profdc9/PicoAlt/README.md

# Pico Alt

This is a simplified Pi Pico board that can be fabricated by JLCPCB.  I customized it to add more flash, a linear regulator, and to be easier to modify if needed.

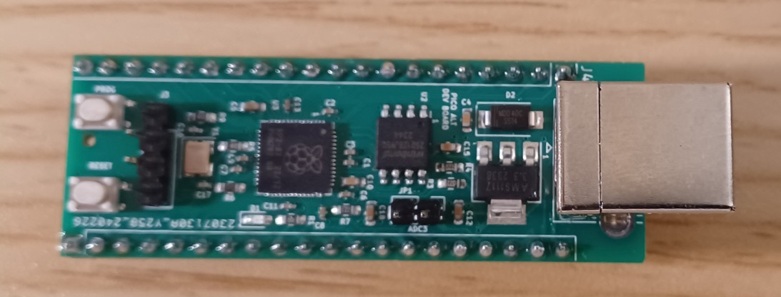
[picture p1: PicoAltPhoto.jpg]

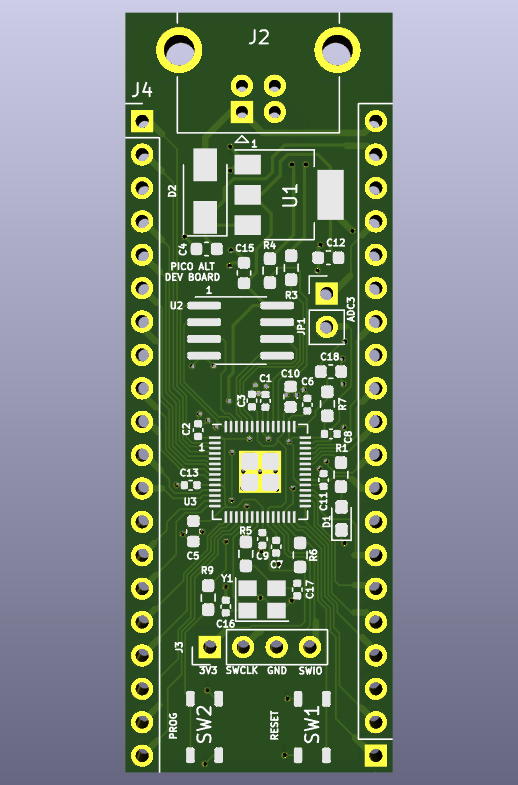
[picture p2: PicoAlt.png]

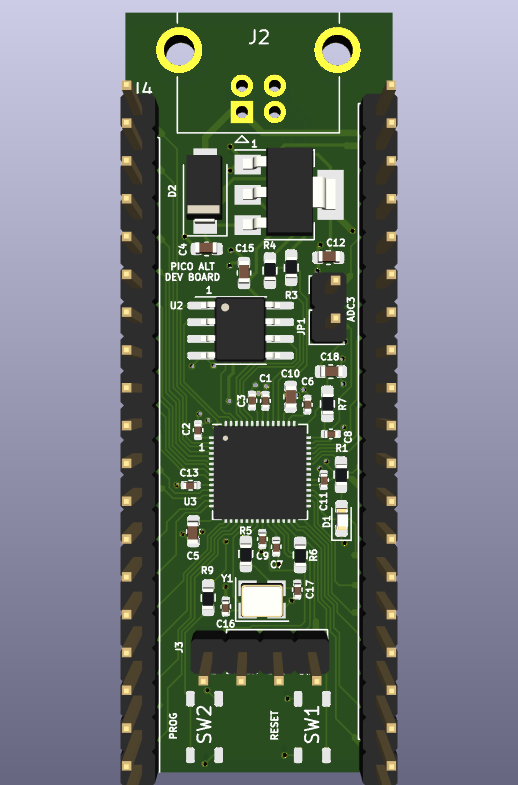
[picture p3: PicoAltComponents.png]
