profdc9/PicoAlt/PicoAlt-schematic.pdf

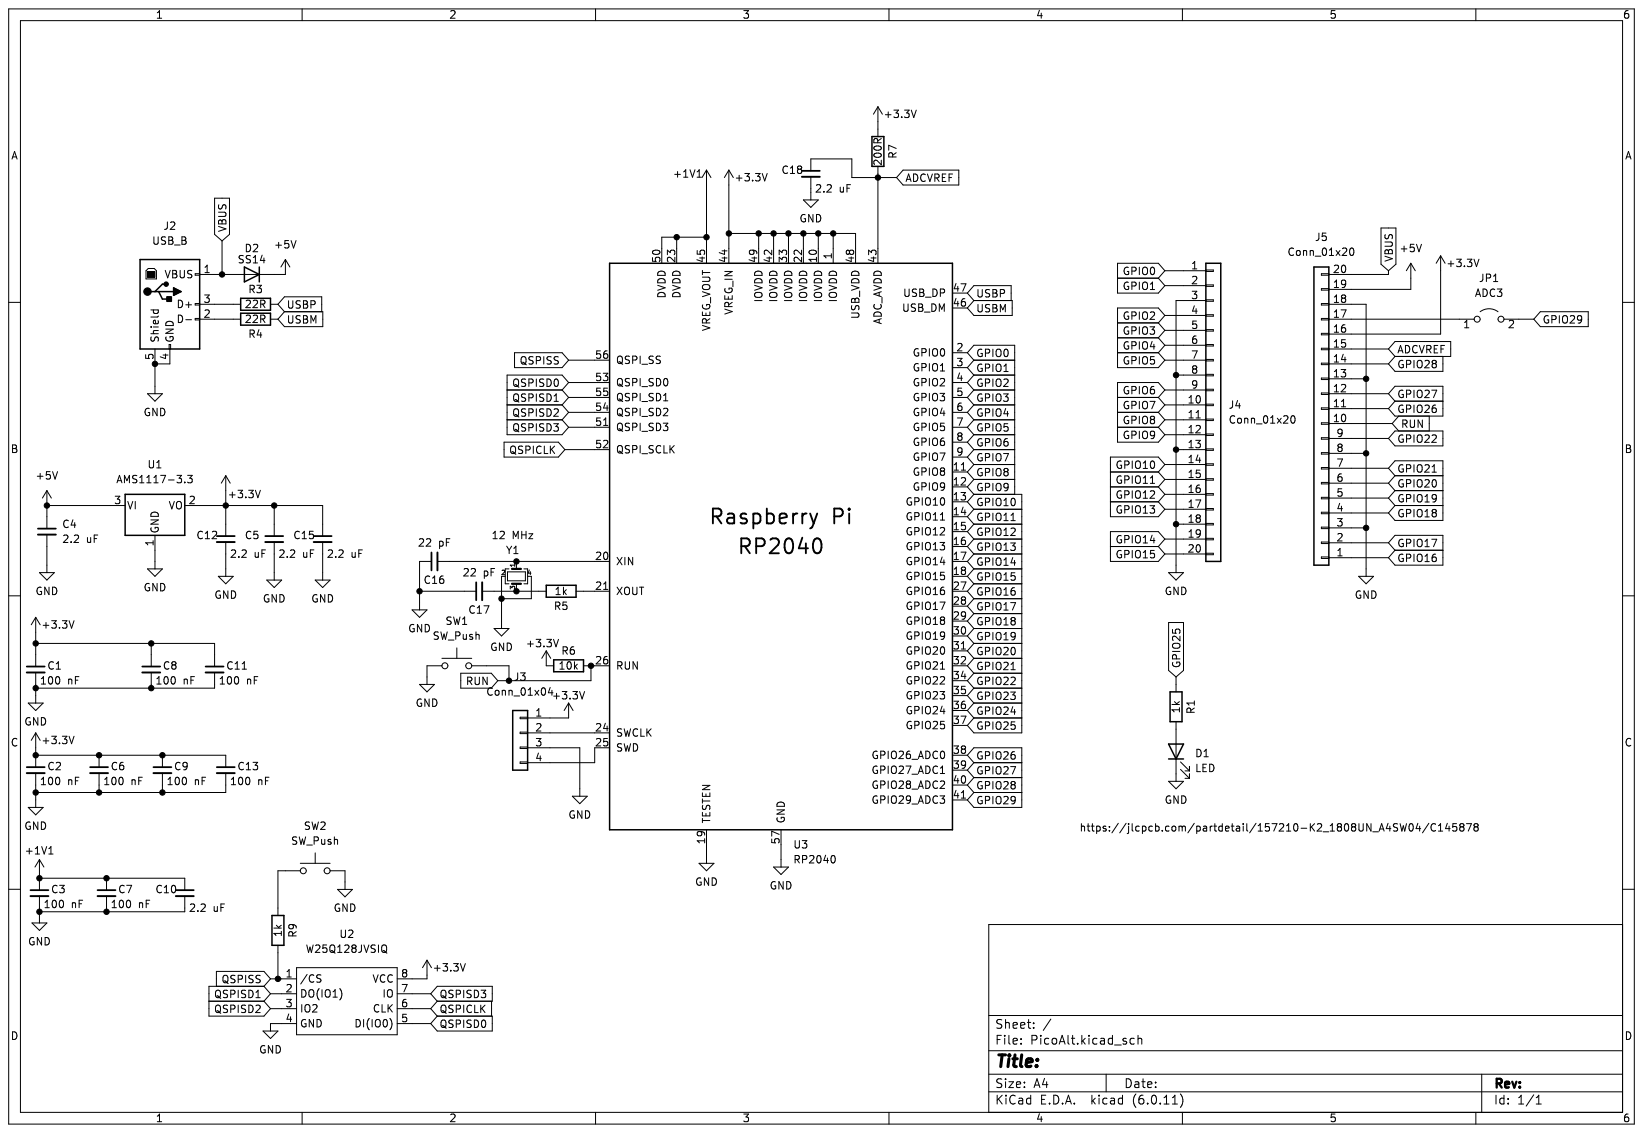
[picture p4: page 1]
