profdc9/PicoAlt/PicoAlt.kicad_pcb

## KiCad design PicoAlt.kicad_pcb (2024-02-26)

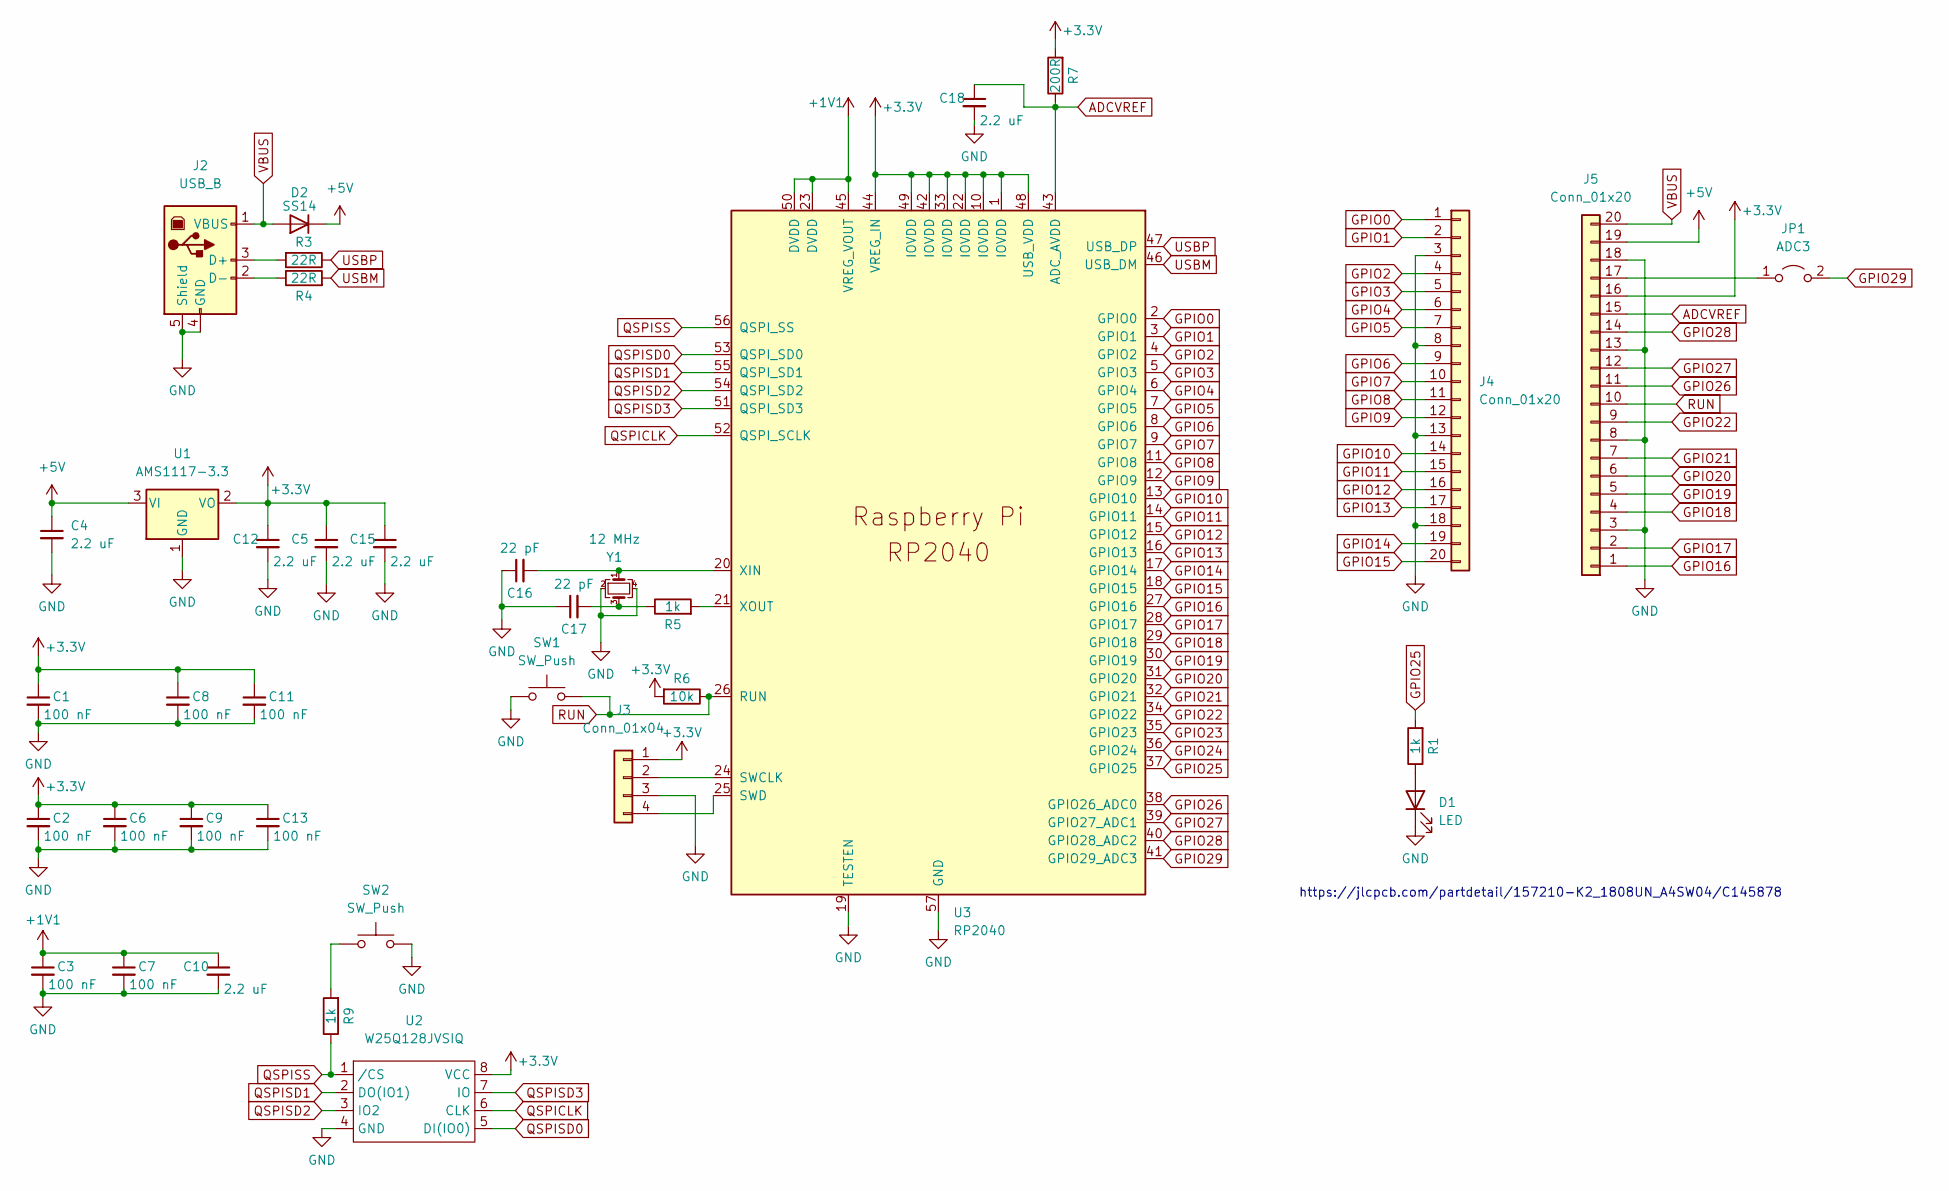
[picture p5: schematic PicoAlt.kicad_sch]

Parts:
C1, C2, C3, C6, C7, C8, C9, C11, C13: 100 nF; C_0402_1005Metric; LCSC C307331
C4, C5, C10, C12, C15, C18: 2.2 uF; C_0603_1608Metric; LCSC C23630
C16, C17: 22 pF; C_0402_1005Metric; LCSC C1555
D1: LED; LED_0603_1608Metric_Pad1.05x0.95mm_HandSolder; LCSC C2286
D2: SS14; D_SMA; LCSC C2480
J2: USB_B; USB_B_OST_USB-B1HSxx_Horizontal
J3: Conn_01x04; PinHeader_1x04_P2.54mm_Vertical
J4, J5: Conn_01x20; PinHeader_1x20_P2.54mm_Vertical
JP1: ADC3; PinHeader_1x02_P2.54mm_Vertical
R1, R5, R9: 1k; R_0603_1608Metric_Pad0.98x0.95mm_HandSolder; LCSC C21190
R3, R4: 22R; R_0603_1608Metric_Pad0.98x0.95mm_HandSolder; LCSC C23345
R6: 10k; R_0603_1608Metric_Pad0.98x0.95mm_HandSolder; LCSC C25804
R7: 200R; R_0603_1608Metric_Pad0.98x0.95mm_HandSolder; LCSC C22962
SW1, SW2: SW_Push; K2-1808UN; LCSC C145878
U1: AMS1117-3.3; SOT-223-3_TabPin2; LCSC C6186
U2: W25Q128JVSIQ; SOIC-8_3.9x4.9mm_P1.27mm_mod
U3: RP2040; QFN-56-1EP_7x7mm_P0.4mm_EP3.2x3.2mm; LCSC C2040
Y1: 12 MHz; Crystal_SMD_3225-4Pin_3.2x2.5mm; LCSC C9002

Connections:
+1V1: C3.1, C7.1, C10.1, U3.23 (DVDD), U3.45 (VREG_VOUT), U3.50 (DVDD)
+3.3V: C1.1, C2.1, C5.1, C6.1, C8.1, C9.1, C11.1, C12.1, C13.1, C15.1, J3.1, J5.16, R6.2, R7.2, U1.2 (VO), U2.8 (VCC), U3.1 (IOVDD), U3.10 (IOVDD), U3.22 (IOVDD), U3.33 (IOVDD), U3.42 (IOVDD), U3.44 (VREG_IN), U3.48 (USB_VDD), U3.49 (IOVDD)
+5V: C4.1, D2.1 (K), J5.19, U1.3 (VI)
ADCVREF: C18.1, J5.15, R7.1, U3.43 (ADC_AVDD)
GND: C1.2, C2.2, C3.2, C4.2, C5.2, C6.2, C7.2, C8.2, C9.2, C10.2, C11.2, C12.2, C13.2, C15.2, C16.1, C17.1, C18.2, D1.1 (K), J2.4 (GND), J2.5 (Shield), J3.3, J4.3, J4.8, J4.13, J4.18, J5.3, J5.8, J5.13, J5.18, SW1.1, SW2.2, U1.1 (GND), U2.4 (GND), U3.19 (TESTEN), U3.57 (GND), Y1.2, Y1.4
GPIO0: J4.1, U3.2 (GPIO0)
GPIO1: J4.2, U3.3 (GPIO1)
GPIO2: J4.4, U3.4 (GPIO2)
GPIO3: J4.5, U3.5 (GPIO3)
GPIO4: J4.6, U3.6 (GPIO4)
GPIO5: J4.7, U3.7 (GPIO5)
GPIO6: J4.9, U3.8 (GPIO6)
GPIO7: J4.10, U3.9 (GPIO7)
GPIO8: J4.11, U3.11 (GPIO8)
GPIO9: J4.12, U3.12 (GPIO9)
GPIO10: J4.14, U3.13 (GPIO10)
GPIO11: J4.15, U3.14 (GPIO11)
GPIO12: J4.16, U3.15 (GPIO12)
GPIO13: J4.17, U3.16 (GPIO13)
GPIO14: J4.19, U3.17 (GPIO14)
GPIO15: J4.20, U3.18 (GPIO15)
GPIO16: J5.1, U3.27 (GPIO16)
GPIO17: J5.2, U3.28 (GPIO17)
GPIO18: J5.4, U3.29 (GPIO18)
GPIO19: J5.5, U3.30 (GPIO19)
GPIO20: J5.6, U3.31 (GPIO20)
GPIO21: J5.7, U3.32 (GPIO21)
GPIO22: J5.9, U3.34 (GPIO22)
GPIO23: U3.35 (GPIO23)
GPIO24: U3.36 (GPIO24)
GPIO25: R1.2, U3.37 (GPIO25)
GPIO26: J5.11, U3.38 (GPIO26_ADC0)
GPIO27: J5.12, U3.39 (GPIO27_ADC1)
GPIO28: J5.14, U3.40 (GPIO28_ADC2)
GPIO29: JP1.2 (B), U3.41 (GPIO29_ADC3)
unnamed: C16.2, U3.20 (XIN), Y1.1
unnamed: C17.2, R5.1, Y1.3
unnamed: D1.2 (A), R1.1
unnamed: J2.2 (D-), R4.1
unnamed: J2.3 (D+), R3.2
unnamed: J3.2, U3.24 (SWCLK)
unnamed: J3.4, U3.25 (SWD)
unnamed: J5.17, JP1.1 (A)
unnamed: R5.2, U3.21 (XOUT)
unnamed: R9.2, SW2.1
QSPICLK: U2.6 (CLK), U3.52 (QSPI_SCLK)
QSPISD0: U2.5 (DI(IO0)), U3.53 (QSPI_SD0)
QSPISD1: U2.2 (DO(IO1)), U3.55 (QSPI_SD1)
QSPISD2: U2.3 (IO2), U3.54 (QSPI_SD2)
QSPISD3: U2.7 (IO), U3.51 (QSPI_SD3)
QSPISS: R9.1, U2.1 (/CS), U3.56 (QSPI_SS)
RUN: J5.10, R6.1, SW1.2, U3.26 (RUN)
USBM: R4.2, U3.46 (USB_DM)
USBP: R3.1, U3.47 (USB_DP)
VBUS: D2.2 (A), J2.1 (VBUS), J5.20

Notes on the sheet:
https://jlcpcb.com/partdetail/157210-K2_1808UN_A4SW04/C145878

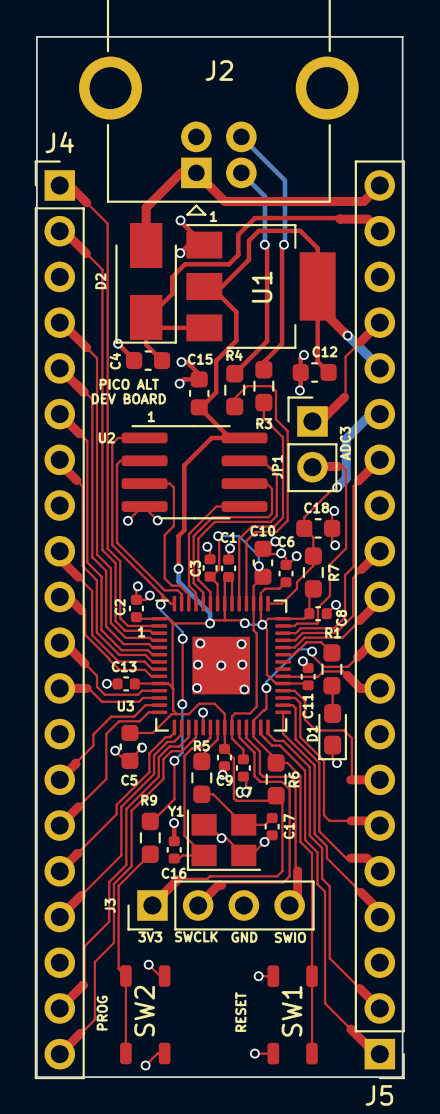
[picture p6: board PicoAlt.kicad_pcb from above]

Board: 2 copper layers, 20.3 x 57.8 mm, 37 parts (0 on the bottom side), 53 nets.
