profdc9/PicoAlt/(commit log)

2024-02-24 JLCPCB submit
    [PicoAlt-B_Cu.gbr, PicoAlt-B_Mask.gbr, PicoAlt-B_Paste.gbr, PicoAlt-B_Silkscreen.gbr, PicoAlt-CuBottom.gbr, PicoAlt-CuTop.gbr, PicoAlt-EdgeCuts.gbr, PicoAlt-Edge_Cuts.gbr]
2024-02-24 Modified for bigger SOIC-8 footprint
    [PicoAlt-CuBottom.gbr, PicoAlt-CuTop.gbr, PicoAlt-EdgeCuts.gbr, PicoAlt-MaskBottom.gbr, PicoAlt-MaskTop.gbr, PicoAlt-NPTH.drl, PicoAlt-PTH.drl, PicoAlt-PasteBottom.gbr]
2024-02-26 JLCPCB #2
    [PicoAlt-CuBottom.gbr, PicoAlt-CuTop.gbr, PicoAlt-EdgeCuts.gbr, PicoAlt-MaskBottom.gbr, PicoAlt-MaskTop.gbr, PicoAlt-NPTH.drl, PicoAlt-PTH.drl, PicoAlt-PasteBottom.gbr]
